Blexalmighty/Keyguard-Final-Year-Project/(commit log)

2026-09-11 Fix blank device cards in BLE scan list and other updates
    [keyguard_esp32c3.ino]
2026-09-12 Advertise one 8-character name so the keyholder is not nameless
    A legacy BLE advertisement holds 31 bytes. The flags take 3 and the
    128-bit service UUID takes 18, leaving 10 for a 2-byte AD header plus the
    name — 8 characters. "BLE-Keyholder" needs 15, and the ESP32 BLE library
    discards an overflowing field without reporting it: BLEAdvertisementData
    ::addData returns early, and the auto-advertising path quietly relocates
    the name to the scan response. The device therefore advertised its
    service UUID but no name, which is why it appeared in the app's scan list
    as a row with no name on it that still connected when tapped.
    Both packets are now built explicitly rather than left to the library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
2026-09-12 Show one nearby list, notify on link changes, expire location history
    Scan tab: remove the All nearby / Keyholders only filter and everything
    behind it (ScanFilter, the field, getter and setter). A keyholder hidden
    behind the wrong chip is indistinguishable from one that is not there.
    Ordering does the filter's real job instead: keyholders first, then by
    signal strength.
    Notifications: post on connect and disconnect, and add a distinct
    out-of-range notice for the owner's configured alert distance, separate
    from the existing halfway warning. Connection notices get their own
    channel at default importance so they can be muted without muting the
    warning that matters. The notification permission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
2026-09-12 Stop the scan driving whole-app rebuilds
    Three changes, all the same shape: work was being repeated for frames
    that came out identical.
    KeyGuardApp watched the entire BleService to read one bool. That made it
    a listener of all ~60 notifyListeners() calls in the service, including
    the RSSI poll every two seconds and every batch of scan results, which
    with continuousUpdates arrive several times a second. Each one rebuilt
    MaterialApp and therefore MainNavigation and all four screens in its
    IndexedStack. A Selector on darkModeEnabled keeps the instant theme flip
    without the rest.
    HistoryScreen reads exactly one value but stays mounted on every tab, so
    it was re-grouping up to 200 events by day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
2026-09-14 Take positions from the phone, not the keyholder
    The keyholder's GPS module could only be read over a live BLE link, so
    `requestLocation()` — a write of `GETLOC:` and nothing else — was unanswerable
    at the one moment a position is worth having: the link dropping. Every
    disconnect row in History was stamped with whatever the module last managed to
    report, which on a unit in a pocket or a bag was often nothing at all.
    Positions now come from this phone's receiver, via PhoneLocationService. A
    keyholder that does have a module is still asked when there is a link, so it
    keeps contributing, but its answer is no longer waited for.
    Events are logged the instant they happen with whatever cached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
2026-09-14 Rename to Find X / Find Me, and fix three reported faults
    The app is Find X; the hardware advertises itself as Find Me.
    Rename
    User-facing strings, window titles and manifests only. Deliberately
    left alone: the Dart package name, the Android applicationId and
    namespace, the Kotlin package path, the iOS/macOS bundle identifiers,
    the desktop BINARY_NAMEs and the firmware directory. Changing the
    applicationId would make this a different app to the Play Store and
    break updates for anyone already running it; the rest are internal
    identifiers no user ever sees.
    Notification channel ids (keyguard_proximity, keyguard_link) are also
    unchanged on purpose. A channel id is the key An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
    [keyguard_esp32c3.ino, main.cpp]
2026-09-23 Become FindX and FindMe, drop Wi-Fi, push the phone's position to the board
    Eight things the owner asked for, and they turn out to be four.
    RENAME. The app is FindX, the keyholder is FindMe — no spaces, everywhere.
    BLE matches advertised names byte for byte, so the spaced spelling that
    shipped briefly is kept as `BleNames.legacySpaced` and normalised on display:
    dropping it would leave already-flashed boards unrecognised, and "the app
    stopped seeing my device" is worse than carrying one extra string. The Dart
    package stays `keyguard` — it is in every import and never on screen.
    WI-FI AND CLOUD REPORTING, GONE. These were one feature wearing three hats.
    The keyholder's Wi-Fi existed onl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
2026-09-25 Draw a real map, name the place, and trim the buzzer to two tones
    The location card showed a coordinate grid and, underneath it, the phone's
    IP address. Neither answers the question being asked, which is *where is
    it*: an IP address is the address of whatever network equipment the phone
    sits behind, and "6.5186, 4.5218" is not a place. The card now draws real
    cartography and names the building.
    Reverse geocoding (services/geocoding_service.dart, new). OpenStreetMap's
    reverse endpoint at zoom 18 names the nearest mapped feature, so the label
    becomes "Amphitheatre, OAU" rather than "Ile-Ife, Nigeria". Android's own
    Geocoder cannot do this — it returns postal components, so its best answer
    i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
    [keyguard_esp32c3.ino]
2026-09-25 Keep the keyholder's copy of the owner's position current
    The device was handed a position exactly once — when the location service
    attached at launch — and then never again unless the owner pressed refresh.
    Its screen therefore showed where the owner had been when the app started,
    which after a walk across campus is worse than showing nothing at all, and
    it is the whole of the complaint that the device "is not receiving the
    current user's location".
    It now re-reads the phone's receiver every two minutes while a keyholder is
    attached, pushing each fix as it arrives. Two minutes is a compromise with
    the battery, not a round number: a continuous stream would hold the GPS on
    all day for a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
2026-09-28 Send the phone's position to a single-channel board, and keep watching after a reboot
    Two faults, both reported as "it keeps showing no GPS".
    The first was the reason nothing arrived. The board in the field exposes
    only the data characteristic and announces its claim state on it in plain
    words — AUTH:unpaired the moment the link comes up, AUTH:ok once a token
    matches. The app's own protocol runs that handshake on a second
    characteristic, so none of those words meant anything here: the ownership
    state stayed `unknown` for the whole session, and pushPhoneLocation reads
    that state to decide whether a write would be refused. It saw "unknown"
    and stayed silent, every time. The phone had a good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
2026-09-28 Name the place and the day in the event log
    The Security log answered "where" with coordinates and "when" with a bare
    clock. Both are recorded facts and neither is a readable answer: 7.521834°
    N, 4.526901° E means nothing without a map in your other hand, and 14:32
    means nothing on a screenshot or on a list scrolled past its date heading.
    Rows now lead with the resolved place name — "Amphitheatre, Obafemi
    Awolowo University" — and keep the coordinates underneath, smaller, because
    the numbers are what was actually measured and the name is a lookup over
    them that only exists with internet. EventModel.locationName and the
    backfill were already there for the Home card; this is the log fin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
2026-09-28 Speak the three commands the board grew: place name, distance limit, too-far
    The firmware moved ahead of the app. Myprojctcode.ino accepts
    LOCATION_NAME:, SET_DIST: and DIST_EXCEEDED:, and announces LOW_POWER: and
    DIST_THRESH: on connect — none of which this app said or understood, so
    three working features sat unused on the hardware.
    LOCATION_NAME: is the one that matters most. The keyholder's screen is
    read by someone who has lost their phone; they cannot look coordinates up,
    because the device they would look them up on is the device they are
    looking for. So the name goes over as soon as a lookup produces one, after
    the coordinates and never instead of them — the lookup needs interne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
2026-10-02 Delete the Wi-Fi provisioning subsystem and 29 unreachable members
    Everything removed here was already unreachable. It is worth saying what
    was checked, because "unused" is easy to claim and easy to get wrong: each
    symbol below was grepped across lib/ and test/ and had exactly one
    occurrence — its own declaration.
    Wi-Fi provisioning, firmware and manifest. The reference sketch still
    accepted WIFI_SET:<ssid>:<password> on a third characteristic, joined the
    owner's network as a station, and held a placeholder for a Firebase upload
    path. The app stopped sending that frame some time ago, so the only thing
    that could reach it was software that was not this app. Gone: the
    characteristic and its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
    [keyguard_esp32c3.ino]
2026-10-02 Fix the GPS frame the board could never receive, and reconnect after a reboot
    Three things the owner reported, and the first was a real protocol fault
    rather than a missing feature.
    **The keyholder never got the phone's position.** The sketch never called
    `BLEDevice::setMTU()`, so the server kept the 23-byte default and a single
    GATT write carried 20 bytes of payload. `PHONE_LOC:7.521834,4.526901` is
    27 bytes: the frame could not arrive whole, ever. The app wrote it, believed
    it had sent it, and the location page sat on "Waiting for location...".
    The reassembly buffer that was supposed to cover that case made it
    permanent. It held anything starting with `PHONE_LOC:` until a comma
    appeared,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
    [Myprojctcode.ino]
2026-10-02 Write the documentation, and delete the diagram that lied about the board
    Six documents, and the thing they have in common is that every figure in them
    was read off the source tree or off the instrument that measured it. Where a
    number is an estimate, it says so; where something was not measured, it says
    that too.
    docs/ARCHITECTURE.md — the codebase as it stands rather than as it was planned.
    Module map with real line counts, the full protocol tables, state machines for
    ownership and connection and device power, the three data-flow journeys that
    matter, the test inventory, and a limits section that states plainly that the
    board cannot be sent an IP address and that its screen shows where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
2026-10-02 Measure the calibration instead of asking the owner to guess it
    The manual card asked the owner to hold the keyholder at exactly one metre and
    drag a slider until it matched a live dBm readout. Both halves of that were
    unreliable: few people hold a measured metre, and a single RSSI reading can be
    more than ten decibels from the truth because of multipath.
    Replaced with a measurement. The owner says which of three distances they are
    standing at, the app takes 24 raw readings over about six seconds and keeps the
    median, and the model's reference term is solved from it:
    txPower = RSSI + 10*n*log10(d)
    At one metre the logarithm vanishes and this is the old manual procedure exactly
    — wit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
2026-10-02 Never stop hunting, and re-check the link after a reboot
    Four things the owner reported, and the two that were real bugs.
    **The app gave up on a device that walked out of range.** `connectToDevice`
    stopped after three failed auto-connect attempts and only set an error
    string. Walking out of range spends those three attempts *during the walk*,
    so coming back an hour later found nothing looking — the exact case the
    retry loop was written for. It now re-arms every time, and spares the radio
    by *slowing down* instead of stopping: a growing backoff of 4 s, 4 s, 4 s,
    8 s, 15 s, 30 s, 60 s, 2 min whose last entry repeats for as long as the
    device is missing. A fresh departure restarts the fast e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
2026-10-03 Make low power actually save power, without dropping the link
    The sketch had a low power mode that did nothing. enableLowPower() called
    esp_pm_configure() with light_sleep_enable = true and the serial log said
    "80MHz, light sleep". The Arduino ESP32 core ships its IDF prebuilt with
    CONFIG_PM_ENABLE unset, so esp_pm_configure() returns ESP_ERR_NOT_SUPPORTED
    and returns immediately. The only line in that function that ever ran was
    setCpuFrequencyMhz(80).
    Light sleep would have been the wrong mechanism even if it had worked. This
    board has no 32.768 kHz crystal (CONFIG_RTC_CLK_SRC_INT_RC=y), so sleep timing
    comes from the internal RC oscillator and drifts percent-wise. BLE connection
    events ha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
    [findme_device.ino]
